jpapasinstru/CDIO3_Eq-4-_Atlektronik/02_Hardware/Source/README.md

Archivos editables: KiCad, Altium, Eagle
