jpapasinstru/CDIO3_Eq-4-_Atlektronik/02_Hardware/Mechanical/carcasas_cdio.docx

Proyecto CDIO 3

Golpeometro

Carcasas (hardware)

Juan pablo ciro Cardoso
1090273382
juanp.ciroc@uqvirtual.edu.co

Santiago Giraldo Dávila

1004917501

Santiago.giraldod@uqvirtual.edu.co

Docente
José Luis Chávez

Para la construcción de la estructura del golpeómetro se utilizó una combinación de materiales que permitieran soportar los impactos generados durante las pruebas y mantener estabilidad mecánica en el sistema. Como base principal se empleó un tablero de madera de alta densidad con dimensiones de 50 cm de ancho por 70 cm de alto. La madera se seleccionó debido a su buena resistencia mecánica y a su capacidad para absorber parte de las vibraciones producidas por los golpes, evitando deformaciones en la estructura.

Con el fin de reforzar la base y reducir movimientos no deseados, se instaló un armazón utilizando perfiles metálicos en ángulo de acero estructural. Este refuerzo permitió aumentar la rigidez del sistema y disminuir las vibraciones que podían afectar las mediciones realizadas por el sensor. Además, sobre esta estructura se construyó el soporte de la pera de boxeo, asegurando una fijación firme para evitar desplazamientos o holguras durante el impacto.

Uno de los aspectos más importantes del diseño fue lograr que la fuerza del golpe se transmitiera de manera controlada hacia la celda de carga. Para esto, se implementó un sistema de guiado junto con un rodachín que restringe movimientos laterales y de torsión, permitiendo únicamente un desplazamiento lineal y vertical. De esta forma, el impacto se dirige directamente sobre la celda de carga de 500 kg, reduciendo errores en la medición causados por fuerzas aplicadas fuera del eje principal.

Finalmente, la pera de boxeo se fijó a la estructura móvil mediante tornillería para garantizar estabilidad durante las pruebas. Por otro lado, la celda de carga fue instalada sobre la base de madera utilizando cinta doble faz industrial, lo que permitió realizar ajustes de posición durante la etapa inicial de pruebas y adquisición de datos con el módulo HX711 antes de realizar una fijación definitiva.

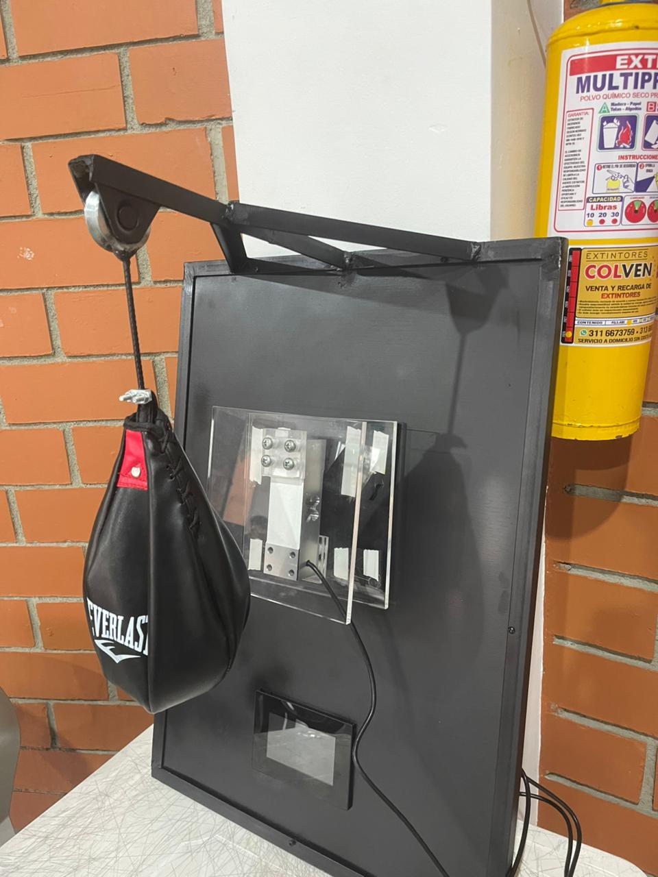
[picture p1: figure]
