jpapasinstru/CDIO3_Eq-4-_Atlektronik/04_Dossier/Atlektronik_expediente_tecnico (1).pdf

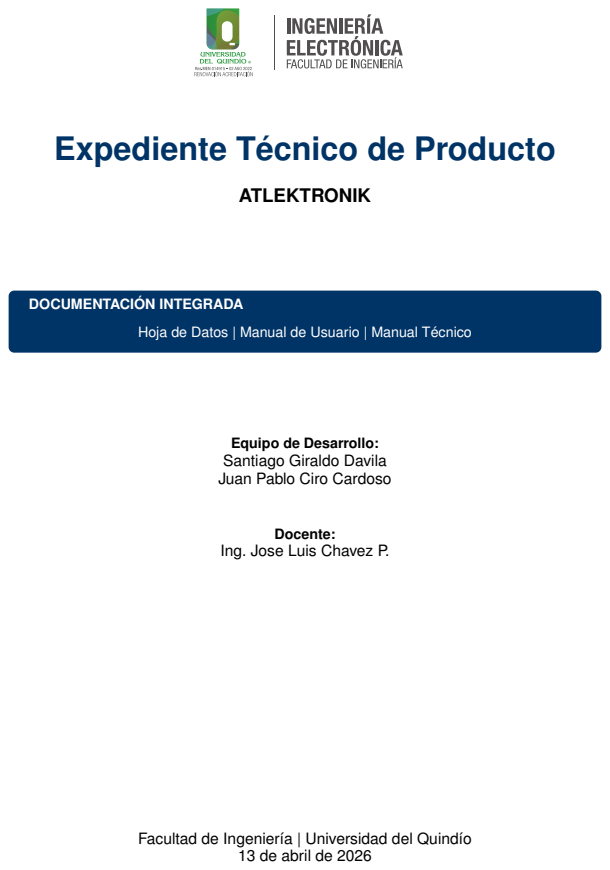
[picture p2: page 1]
ATLEKTRONIK; DOCUMENTACIÓN INTEGRADA; Docente:

Expediente Técnico de Producto

Hoja de Datos | Manual de Usuario | Manual Técnico

Equipo de Desarrollo:
Santiago Giraldo Davila
Juan Pablo Ciro Cardoso

Ing. Jose Luis Chavez P.

Facultad de Ingeniería | Universidad del Quindío

13 de abril de 2026

Proyecto CDIO III: ATLEKTRONIK | Rev. 1.0 - 2026

## Índice

1. HOJA DE DATOS (DATASHEET) | 2
2. MANUAL DE USUARIO | 3
3. MANUAL TÉCNICO | 4
Universidad del Quindío - Ingeniería Electrónica | 1

## 1 HOJA DE DATOS (DATASHEET)

### 1.1 Descripción General

Sistema de medición de fuerza de impacto con capacidad de 1000 kg (9806.65 N), procesamiento basado en ESP32 y visualización HMI en pantalla Nextion de alta corriente.

### 1.2 Especificaciones Eléctricas

Parámetro | Descripción | Valor/Unidad
Voltaje de Entrada | Suministrado por Fuente ATX | 5,0V DC
Corriente Nominal | Requerimiento de Pantalla Nextion | 1,0A
Resolución del Sensor | Módulo ADC HX711 | 24 bits
Rango de Medición | Límite físico de la celda de carga | 0 − 9806,65N
Frecuencia de Muestreo | Tasa de adquisición de datos | 10 − 80 Hz

### 1.3 Pinout (Diagrama de Conexiones)

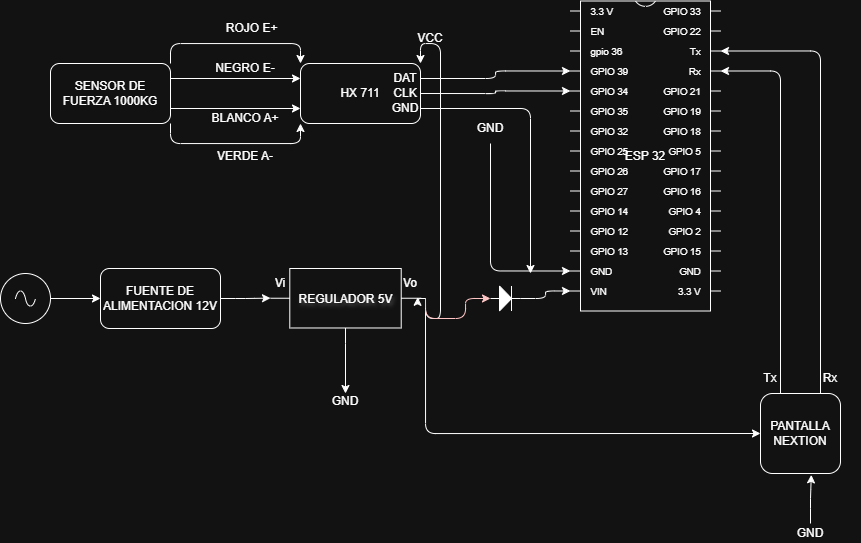
[picture p3: figure]

Figura 1: Diagrama de conexión detallado del sistema.

## 2 MANUAL DE USUARIO

. ADVERTENCIA DE SEGURIDAD

Alimentación: Utilice únicamente una fuente ATX que garantice una corriente mínima de 1,0A en la línea de 5V . Una corriente insuficiente causará fallos en el encendido de la pantalla Nextion.
Conexión AC: No manipule la fuente de poder conectada a la red de 110/220V AC.

### 2.1 Instrucciones de Operación

1. Verifique que el puente de encendido de la fuente ATX esté activo (Cable verde a tierra).
2. Conecte el dispositivo a la salida de 5V (Cables rojos de la fuente).
3. Encienda el sistema y espere la carga de la interfaz en la Nextion.
4. Ejecute el impacto sobre la pera de boxeo.
5. Visualice el valor de fuerza procesado en la pantalla.

## 3 MANUAL TÉCNICO

### 3.1 Arquitectura del Sistema y Conexiones

La arquitectura se basa en un lazo de control abierto donde la fuerza mecánica es convertida en señal eléctrica por el puente de Wheatstone de la celda de carga.

### 3.1.1. Conexión del Sensor (Código de Colores)

Siga estrictamente el siguiente orden de cableado para el módulo HX711:

E+ (Excitation+): Cable ROJO.

E- (Excitation-): Cable NEGRO.

A- (Signal-): Cable BLANCO.

A+ (Signal+): Cable VERDE.

### 3.1.2. Comunicación Serial (HMI Nextion)

Realice el cruce de líneas para habilitar la transmisión de datos:

TX (ESP32): Conecte al pin RX de la Pantalla Nextion.

RX (ESP32): Conecte al pin TX de la Pantalla Nextion.

GND: Asegure una tierra común entre la fuente, la ESP32 y la pantalla.

### 3.2 Lista de Materiales (BOM)

Referencia | Cant. | Especificación Técnica | Función
ESP32 DevKit V1 | 1 | Microcontrolador de 32 bits | Procesamiento
HX711 | 1 | ADC de alta resolución (24 bits) | Interfaz Celda
Celda de Carga | 1 | Tipo Pera - Capacidad 1 Tonelada | Transductor
Pantalla Nextion | 1 | HMI Serial - Req. 5V @ 1,0A | Visualización
Fuente ATX | 1 | Reciclada (110/220V AC a 5V DC) | Alimentación
1N5817 | 2 | Diodo Schottky de baja caída | Protección

### 3.3 Plan de Mantenimiento Preventivo

Actividad | Frecuencia | Procedimiento

Calibración de Fuerza 1000 impactos Compare con masa patrón de 10kg.
Limpieza de Fuente | Mensual | Retire residuos de polvo con aire comprimido.
Revisión de Cableado | Trimestral | Verifique continuidad en los cables de la galga.
