jpapasinstru/CDIO3_Eq-4-_Atlektronik/04_Dossier/HERRAMIENTAS DE AUDITORIA Y PLANEACIÓN.pdf

HERRAMIENTAS DE AUDITORIA Y PLANEACIÓN

CDIO lll

SANTIAGO GIRALDO DAVILA

JUAN PABLO CIRO CARDOSO

JOSE LUIS CHAVEZ

UNIVERSIDAD DEL QUINDIO

ARMENIA-QUINDIO

2026-l

1-Matriz de inventario

Es el control logístico que asegura la disponibilidad física de los insumos básicos, como resistencias y fuentes de voltaje, necesarios para las pruebas de laboratorio. Sirve para identificar rápidamente qué elementos ya están en stock y cuáles representan un riesgo para el cronograma si no se adquieren a tiempo.

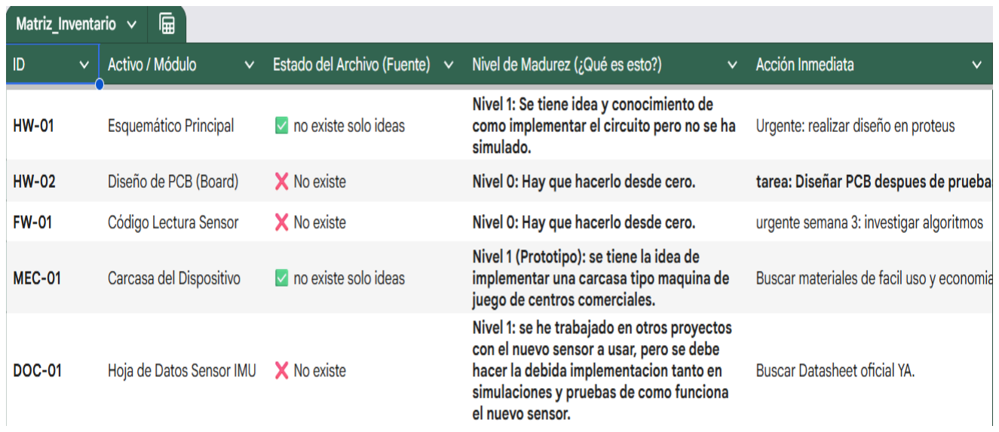
[picture p4: figure]

2-Inventario de subsistemas

Organiza los elementos del proyecto por bloques funcionales: el sistema de control (ESP32), el sistema de visualización (Nextion), el acondicionamiento de señal (HX711/AD620) y la estructura mecánica. Permite verificar la compatibilidad entre las diferentes etapas del "golpeómetro".

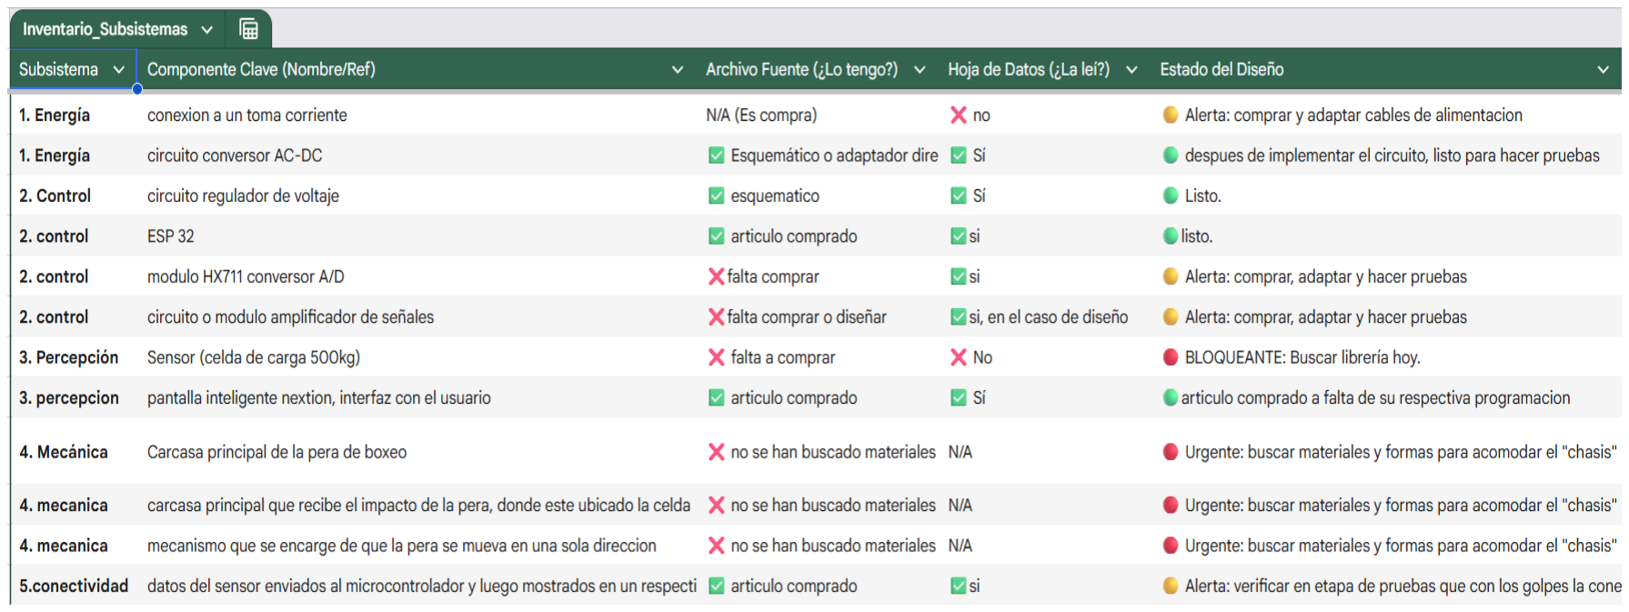
[picture p5: figure]

3-Auditoria de diseño

Documenta el proceso de revisión crítica del prototipo, donde se justifican cambios técnicos como la transición del sensor FSR a la celda de carga y el rediseño del mecanismo de la pera hacia un movimiento unidireccional. Evalúa si el diseño actual cumple con los requerimientos de precisión y resistencia.

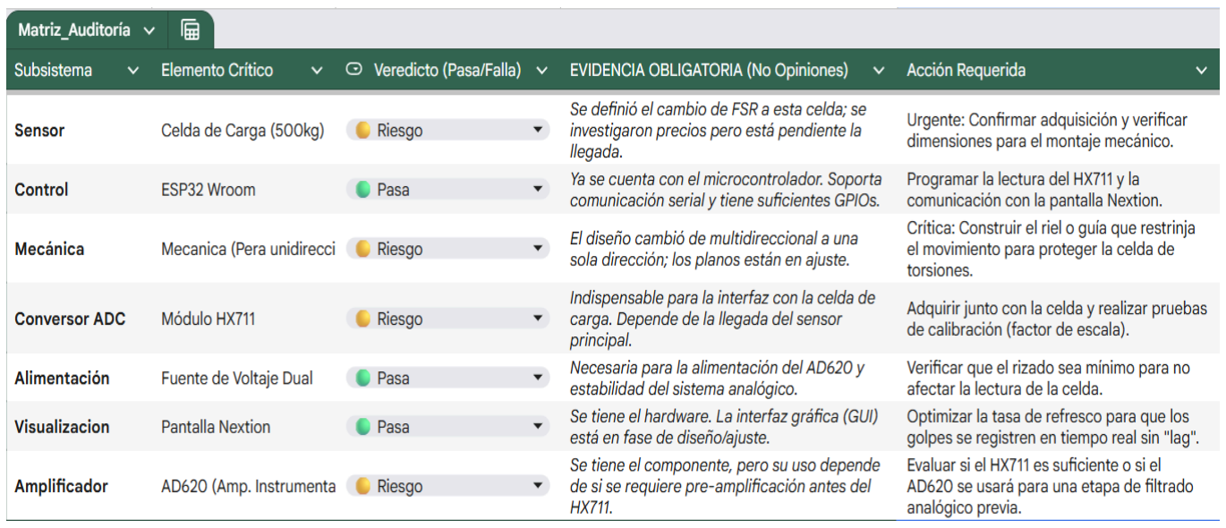
[picture p6: figure]

4- BOM sourcing

Centraliza la gestión de suministros, detallando cada componente electrónico y mecánico (desde la celda de carga de 500kg hasta el ESP32). Registra proveedores, costos y el estado de los pedidos para evitar retrasos en la etapa de implementación.

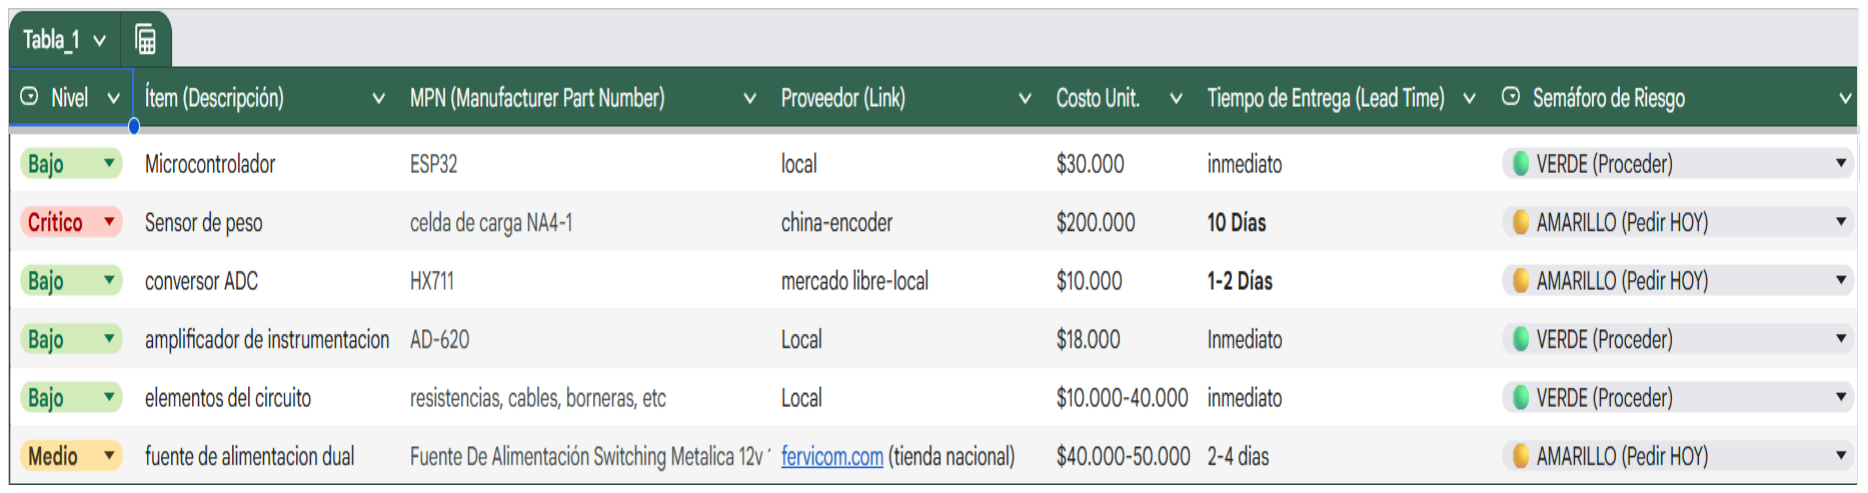
[picture p7: figure]

5-Planificador Sprint

Es la hoja de ruta del proyecto donde se desglosan las tareas críticas de compra, diseño y validación. Define los plazos de ejecución (como las pruebas de la celda entre las semanas 7 y 8) y establece los criterios de aceptación para asegurar que cada fase se complete con éxito antes de avanzar.

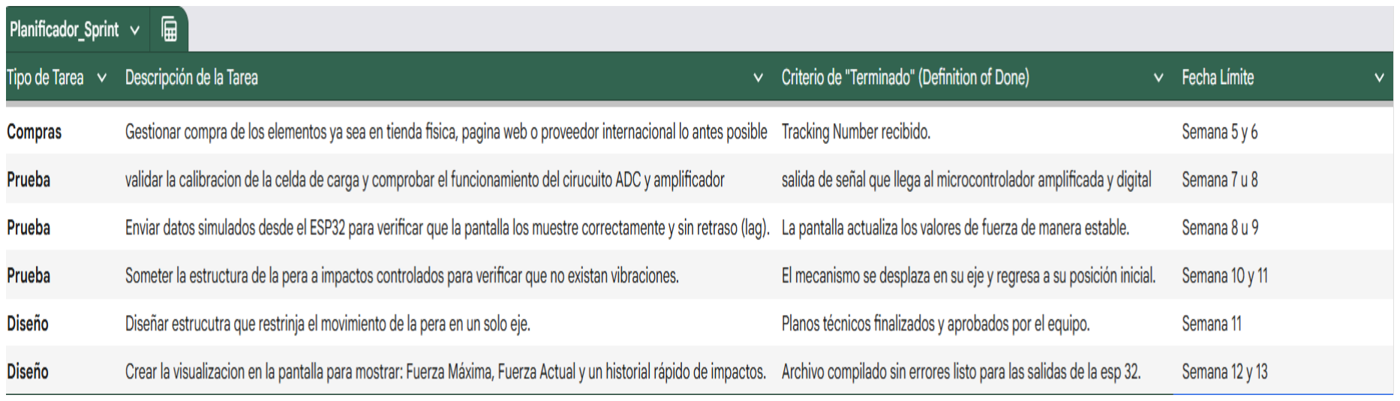
[picture p8: figure]

Diseño del prototipo en 3D (mecanismo)

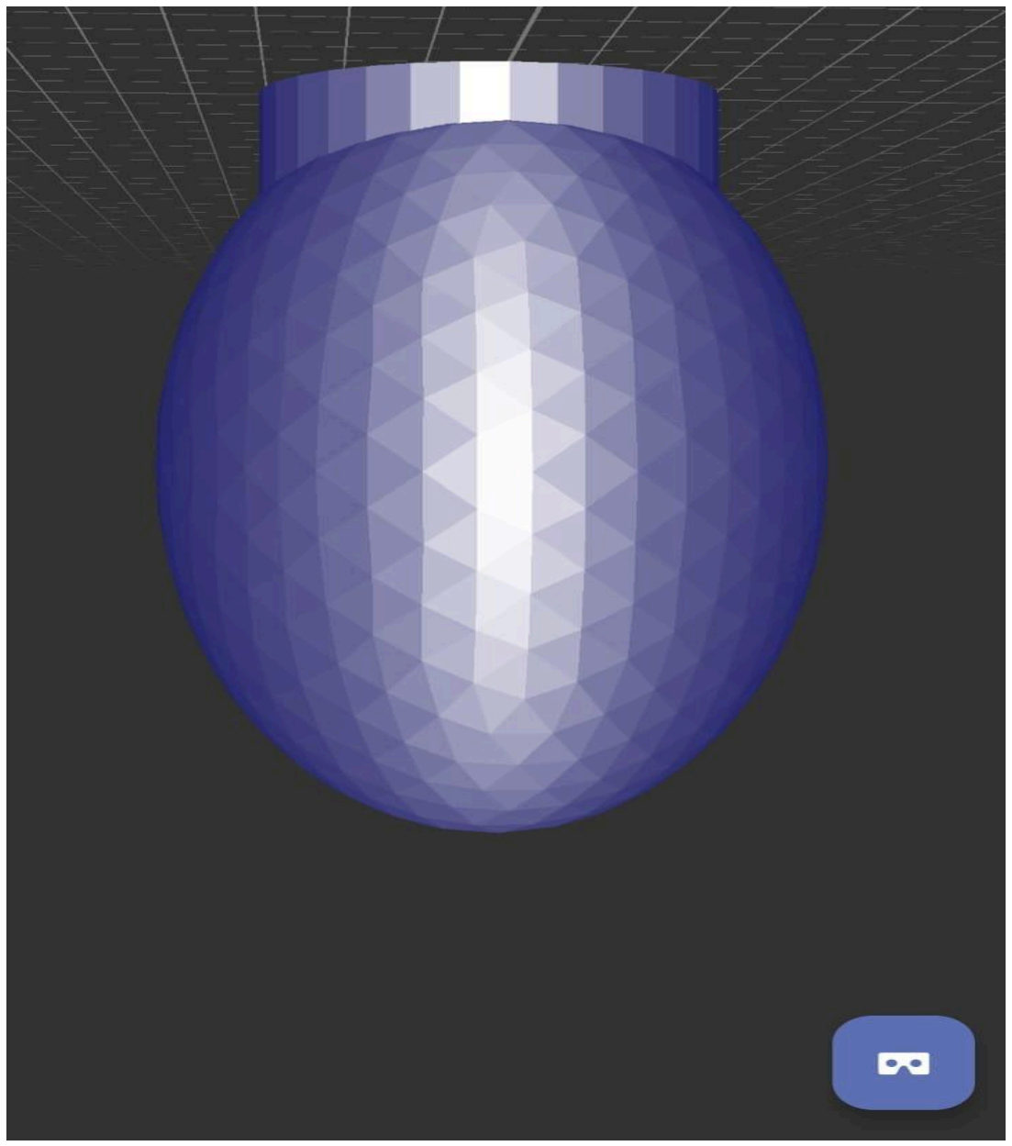
[picture p9: figure]
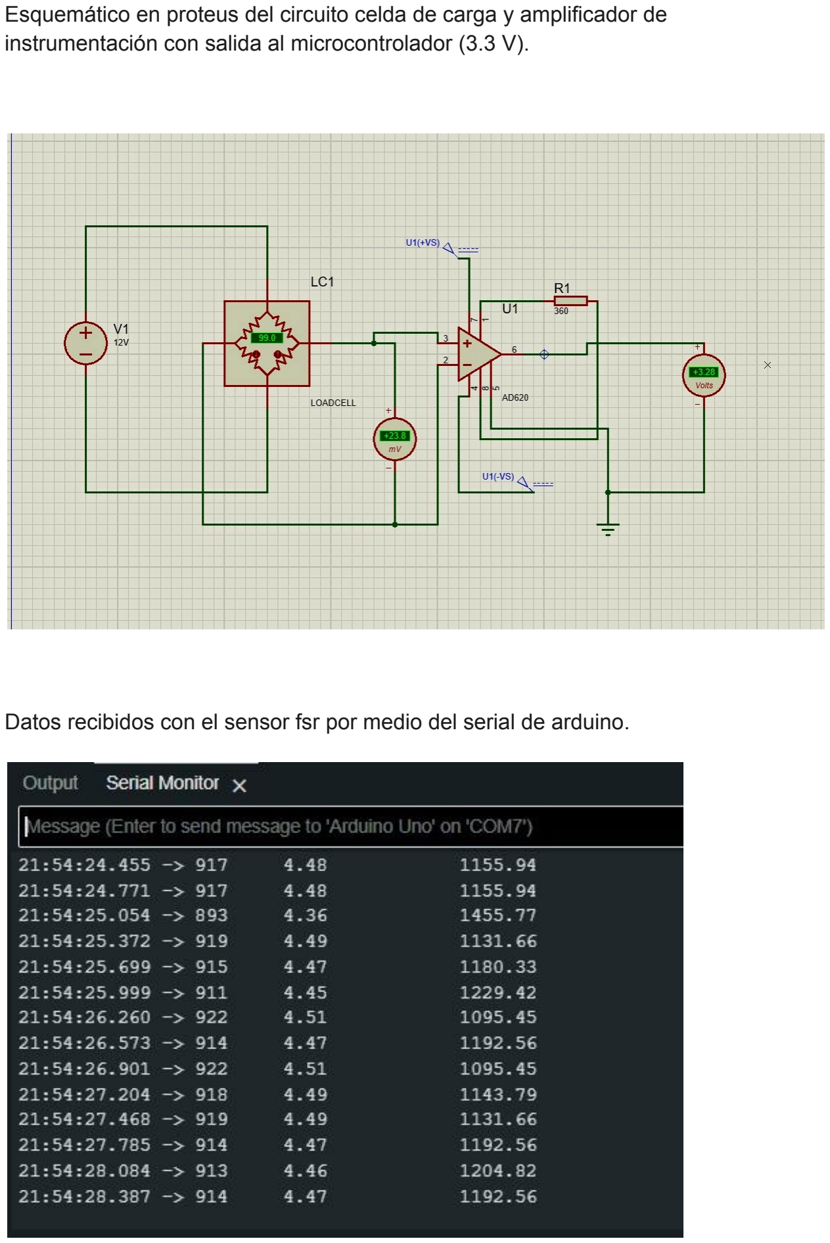
[picture p10: page 6]

Esquemático en proteus del circuito celda de carga y amplificador de instrumentación con salida al microcontrolador (3.3 V).

Datos recibidos con el sensor fsr por medio del serial de arduino.

Prototipo realizado con el profesor jorge alejandro aldana con estralandia mediante el cual se dio a conocer a pequeña escala de como podría ser la implementación del sistema de medición de fuerza de golpeo enfocada en un gimnasio de la liga del quindio de boxeo.

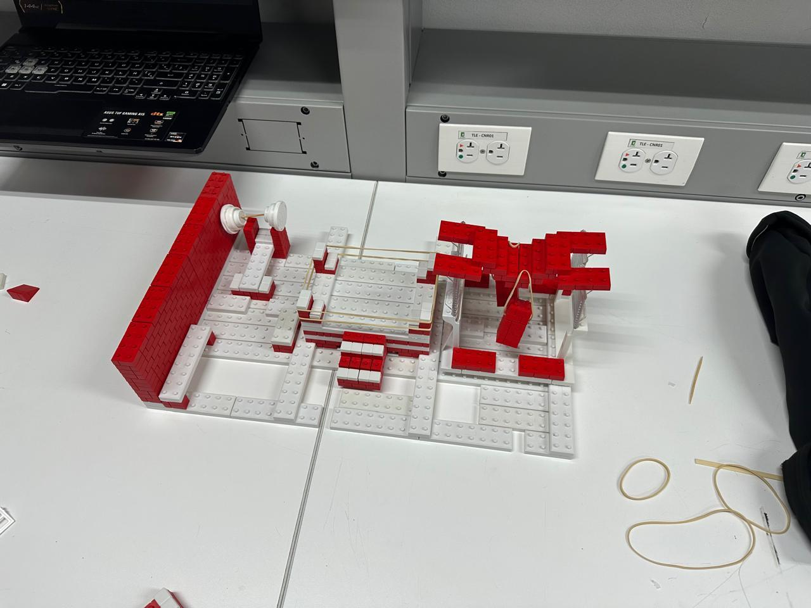
[picture p11: figure]

Auditoria tecnica

Evidencias del hardware “en camino” (sourcing).

Orden de compra del sensor principal (celda de carga).

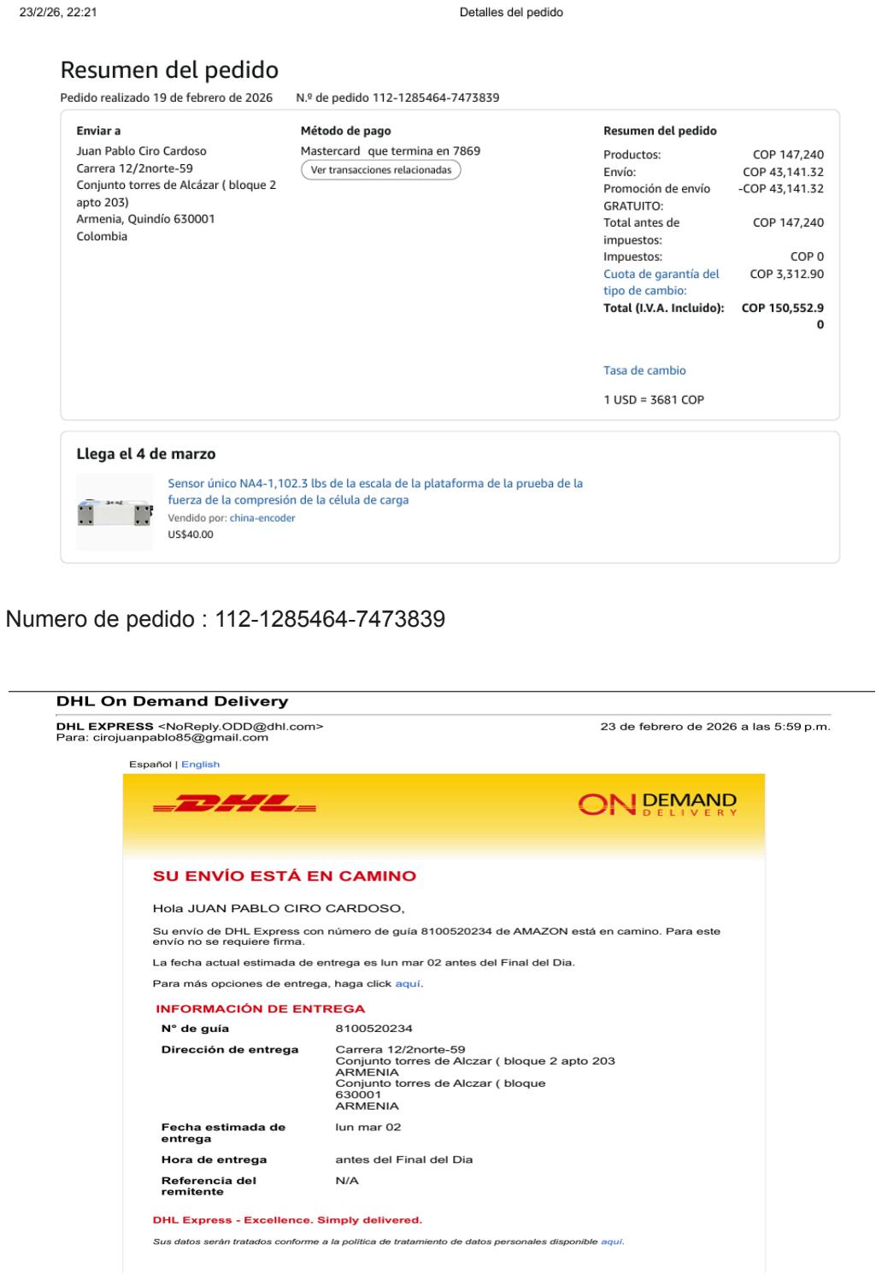
[picture p12: page 8]

Numero de pedido : 112-1285464-7473839

Descripción del sensor (cuadro comparativo con las especificaciones propuestas en CDIO ll):

Parámetro / Requisito | Valor Objetivo (Planeación) | Especificació n Celda NA4 | ¿Cumple ? | Observación Técnica
Rango de Medición | 0 a 5000 N (502 kg) | Capacidades de 60 a 800kg | SÍ | La capacidad de hasta 800 kg cubre perfectament e el rango de un golpe recreativo.
Repetibilida d | < 5% | +/- 0.02% F.S. | SÍ | La precisión de la celda es muy superior al requisito mínimo del 5%.
Protección / Ambiente | Uso rudo (Golpe de boxeo) | Grado de protección IP66/IP67 | SÍ | El sellado IP67 garantiza durabilidad frente a polvo y humedad durante las pruebas.

Sobrecarga Segura | No especificado explícitament e | <150% F.S. | SÍ | Soporta hasta 750 kg sin daño permanente, ideal para impactos accidentales fuertes.
Voltaje de Salida | Salida analógica para ADC | 2.0 mV/V +/-5% | SÍ | Compatible con el módulo HX711 mencionado en su planificador.
