jpapasinstru/CDIO3_Eq-4-_Atlektronik/04_Dossier/desarrollo del proyecto en ciclos i´pac.docx

INFORME DE DESARROLLO DEL PROYECTO GOLPEÓMETRO MEDIANTE CICLOS IPAC

CURSO CDIO 3

Integrantes:

Juan Pablo Ciro Cardoso

1090273382

Juanp.ciroc@uqvirtual.edu.co

Santiago Giraldo Dávila

1004917501

Santiago.giraldod@uqvirtual.edu.co

Facultad de ingeniería

Programa de ingeniería electrónica

Curso Cdio 3

Docente

José Luis Chávez P.

Introducción: El desarrollo del proyecto Golpeómetro se llevó a cabo siguiendo la metodología CDIO junto con la organización por ciclos IPAC, permitiendo dividir el trabajo en diferentes etapas y mantener un control más claro tanto del avance técnico como de la gestión del proyecto. Durante el proceso se utilizaron herramientas de seguimiento tipo Kanban para organizar tareas de diseño, implementación, pruebas y validación, facilitando la distribución del trabajo dentro del equipo.

El proyecto tuvo como objetivo el diseño de un sistema capaz de medir la fuerza de impacto de un golpe utilizando una celda de carga, un sistema de adquisición basado en ESP32 y una interfaz gráfica para la visualización de datos. A medida que avanzó el desarrollo, fue necesario abordar problemas mecánicos, electrónicos y de procesamiento de señales, por lo que el proyecto se dividió en varios ciclos IPAC enfocados en resolver necesidades específicas del sistema.

IPAC I – Planeación inicial y selección de componentes

Durante la primera etapa del proyecto se definieron los requerimientos generales del sistema y la arquitectura principal del golpeómetro. En esta fase se establecieron las variables más importantes del diseño, como el rango de fuerza esperado, el tipo de sensor a utilizar, la capacidad de procesamiento y la forma en que se visualizarían los datos obtenidos.

Inicialmente se realizó la búsqueda y validación de los componentes principales mediante revisión de hojas de datos y análisis de compatibilidad entre módulos. Para la adquisición de fuerza se seleccionó una celda de carga tipo Single Point de 500 kg, junto con el módulo HX711 para el acondicionamiento y digitalización de la señal. Como unidad principal de procesamiento se utilizó un ESP32 debido a la cantidad de periféricos disponibles y su facilidad para manejar comunicación serial y procesamiento de datos en tiempo real. Además, se escogió una pantalla Nextion para la interfaz gráfica del sistema.

En esta etapa también se organizó la compra de materiales y componentes necesarios para la construcción del prototipo. Una vez recibidos y verificados todos los elementos principales, se dio por finalizada la primera fase del proyecto.

IPAC II – Construcción estructural y adquisición de señal

En el segundo ciclo el trabajo se enfocó principalmente en la parte mecánica y en la estabilidad de la señal obtenida desde la celda de carga. Uno de los principales problemas identificados desde el inicio fue que las vibraciones generadas por los impactos podían afectar directamente las mediciones, introduciendo ruido en la señal.

Para solucionar esto, se construyó una base utilizando madera de alta densidad con dimensiones de 50 cm por 70 cm, buscando una estructura resistente y capaz de absorber parte de las vibraciones producidas durante los golpes. Posteriormente, se reforzó el sistema mediante perfiles metálicos en ángulo para aumentar la rigidez de la estructura y evitar deformaciones o movimientos no deseados.

Después de finalizar la estructura principal, se realizó el montaje de la celda de carga y el módulo HX711. Durante esta etapa también se trabajó en el cableado y blindaje de las señales, conectando adecuadamente la malla de protección a tierra para reducir interferencias eléctricas y ruido electromagnético que pudieran afectar las lecturas del sensor.

Finalmente, se realizaron las primeras pruebas de adquisición de datos, verificando que el sistema fuera capaz de registrar señales estables y repetibles desde la celda de carga.

IPAC III – Sistema mecánico de impacto y diseño electrónico

En esta etapa el proyecto se centró en mejorar la forma en que la fuerza del golpe llegaba a la celda de carga. Durante las pruebas iniciales se observó que los impactos diagonales o no completamente centrados, producían errores en las mediciones debido a impactos que no golpeaban la celda de carga en el punto correcto.

Para reducir este problema, se diseñó un mecanismo de guiado que restringe el movimiento únicamente en dirección vertical. El sistema se construyó utilizando soportes metálicos y un rodachín que actúa como guía, permitiendo que la fuerza del golpe se transmita directamente hacia la celda de carga sin movimientos laterales significativos.

A la vez, se trabajó en el diseño de la PCB del sistema utilizando Proteus. En esta fase se definieron los caminos de potencia o alimentación, conexiones del ESP32, alimentación del HX711 y la interfaz con la pantalla Nextion. Posteriormente, la placa pcb fue fabricada mediante la máquina CNC del laboratorio.

También se desarrolló la interfaz gráfica de usuario en la pantalla Nextion, mostrando variables como fuerza máxima, fuerza actual e historial básico de mediciones. Finalmente, se realizaron pruebas de comunicación serial y validación del sistema electrónico completo.

IPAC IV – Integración final y validación del sistema

La última etapa estuvo enfocada en integrar todos los subsistemas y realizar las pruebas finales de funcionamiento. En este punto ya se contaba con la estructura mecánica, el sistema electrónico y la adquisición de datos operando de manera conjunta.

En el software del ESP32 se implementaron filtros en el código para estabilizar las lecturas y reducir las variaciones causadas por rebotes mecánicos después del impacto. Además, se desarrolló un sistema básico de almacenamiento de datos para registrar usuarios y resultados obtenidos durante las pruebas.

Con el fin de mejorar la estabilidad general del prototipo, se añadieron refuerzos adicionales en la base utilizando arena como un peso mayor a la pera, para disminuir vibraciones o errores en el censado. Asimismo, la fijación de la celda de carga pasó de un montaje temporal con cinta industrial a una sujeción casi semi permanente mediante tornillos y pernos a una pared gruesa.

Finalmente, se realizaron pruebas completas de funcionamiento y calibración del sistema, verificando la respuesta del sensor, la estabilidad mecánica y la correcta visualización de datos en la interfaz gráfica. Con esto se logró obtener un prototipo funcional y estable, capaz de medir impactos de forma repetible y con un margen de error reducido.
