jpapasinstru/CDIO3_Eq-4-_Atlektronik/01_Gestion/03 - Acta_Reuniones CDIO lll.docx (2).pdf

## Universidad del Quindío. Programa de Ingeniería Electrónica

# ACTA DE REUNIÓN DEL EQUIPO

Por cada reunión que se agende para el equipo de trabajo, se debe diligenciar esta acta. Las actas deben ser almacenadas en el portafolio.

Número ID. Equipo: | 2K | Nombre del Equipo: | ATLEKTRONIK
Fecha: | [04-02-26] | Hora de Inicio: 11 am | Hora de Finalización: 1 pm
Lugar: | universidad del quindío (bloque ingenieria)
Product Manager: | Relator: | juan pablo ciro cardoso
PROPÓSITO DE LA REUNIÓN: | Validar la viabilidad técnica del prototipo diseñado en CDIO II y determinar si los componentes actuales cumplen con los requerimientos de impacto y precisión.
METAS ALCANZADAS: | 1. Evaluación del prototipo ideal frente a condiciones reales de impacto. 2. Decisión técnica de sustituir el sensor FSR por una celda de carga, debido a la necesidad de mayor precisión y durabilidad. 3. Investigación de mercado y selección de una celda de carga de 500 kg.
TAREAS PENDIENTES Y RESPONSABLES: | 1. Finalizar la compra/adquisición de la celda de carga de 500 kg. Juan Pablo Ciro Cardoso 2. Investigar el módulo amplificador (HX711 o similar) para la nueva celda. Santiago Giraldo Davila
FIRMAS DE LOS ASISTENTES 1 : | 1. SANTIAGO GIRALDO DAVILA Nombre:SANTIAGO GIRALDO DÁVILA. 2. JUAN PABLO CIRO CARDOSO Nombre:JUAN PABLO CIRO CARDOSO
OBSERVACIONES: | Se determinó que los sensores FSR presentaban saturación y poca linealidad para los niveles de fuerza esperados en el "golpeómetro". _______________________________________________________________________________________

1 El integrante que no asista a la reunión no podrá firmar en otra ocasión, en su lugar, debe escribirse “AUSENTE”; sin embargo, si le podrán ser asignadas responsabilidades.

## Acta de Reunión del Equipo

## Universidad del Quindío. Programa de Ingeniería Electrónica

Número ID. Equipo: | 2K | Nombre del Equipo: | ATLEKTRONIK
Fecha: | [11-02-26] | Hora de Inicio: 11 am | Hora de Finalización: 1 pm
Lugar: | universidad del quindío (bloque ingenieria)
Product Manager: | Relator: | juan pablo ciro cardoso
PROPÓSITO DE LA REUNIÓN: | Investigar opciones sobre como adaptar la estructura física al nuevo sensor y cumplir con los estándares de modelado de procesos exigidos.
METAS ALCANZADAS: | 1. Rediseño del mecanismo de la pera para restringir el movimiento a una sola dirección (eje lineal), garantizando que la fuerza se aplique perpendicularmente a la celda de carga. 2. Actualización de la documentación técnica, específicamente el diagrama IDEF0 (siguiendo las correcciones del docente).
TAREAS PENDIENTES Y RESPONSABLES: | 1. Definir el nuevo plano mecánico con el eje de movimiento restringido. Juan Pablo Ciro Cardoso 2. Subir la versión corregida del IDEF0 al informe de avance. Santiago Giraldo Davila
FIRMAS DE LOS ASISTENTES 2 : | 1. SANTIAGO GIRALDO DAVILA Nombre:SANTIAGO GIRALDO DÁVILA. 2. JUAN PABLO CIRO CARDOSO Nombre:JUAN PABLO CIRO CARDOSO
OBSERVACIONES: | Se determinó que el movimiento lineal de la pera es fundamental para asi el impacto sea netamente en la celda de carga. _______________________________________________________________________________________

2 El integrante que no asista a la reunión no podrá firmar en otra ocasión, en su lugar, debe escribirse “AUSENTE”; sin embargo, si le podrán ser asignadas responsabilidades.

## Universidad del Quindío. Programa de Ingeniería Electrónica

Número ID. Equipo: | 2K | Nombre del Equipo: | ATLEKTRONIK
Fecha: | [18-02-26] | Hora de Inicio: 11 am | Hora de Finalización: 1 pm
Lugar: | universidad del quindío (bloque ingenieria)
Product Manager: | Relator: | Santiago Giraldo Davila
PROPÓSITO DE LA REUNIÓN: | Centralizar toda la información técnica y el código fuente del proyecto para asegurar la trazabilidad y el trabajo colaborativo.
METAS ALCANZADAS: | 1. Creación y configuración del repositorio en GitHub para el proyecto. 2. Migración de archivos (código y documentación) al entorno de Git. 3. Organización de la estructura de carpetas (Hardware,Firmware, Software, Dossier).
TAREAS PENDIENTES Y RESPONSABLES: | 1. Subir los últimos cambios de la programación de la celda de carga al repositorio. Juan Pablo Ciro Cardoso 2. Verificar que todos los integrantes tengan acceso y permisos de edición en GitHub. Santiago Giraldo Davila
FIRMAS DE LOS ASISTENTES 3 : | 1. SANTIAGO GIRALDO DAVILA Nombre:SANTIAGO GIRALDO DÁVILA. 2. JUAN PABLO CIRO CARDOSO Nombre:JUAN PABLO CIRO CARDOSO
OBSERVACIONES: | N/A _______________________________________________________________________________________

3 El integrante que no asista a la reunión no podrá firmar en otra ocasión, en su lugar, debe escribirse “AUSENTE”; sin embargo, si le podrán ser asignadas responsabilidades.

## Universidad del Quindío. Programa de Ingeniería Electrónica

Número ID. Equipo: | 2K | Nombre del Equipo: | ATLEKTRONIK
Fecha: | [25-02-26] | Hora de Inicio: 11 am | Hora de Finalización: 1 pm
Lugar: | Universidad del quindío (bloque ingenieria)
Product Manager: | Relator: | Santiago Giraldo Davila
PROPÓSITO DE LA REUNIÓN: | Socializar sobre el github, funcionamiento, carpetas, y tareas futuras
METAS ALCANZADAS: | 1. Se subieron los archivos del entregable. 2. Se organizo un poco mejor el tablero canvas. 3. Se distribuyeron mejor las tareas a realizar cuando lleguen los implementos.
TAREAS PENDIENTES Y RESPONSABLES: | 1. Investigar sobre la base de donde estara ubicada nuestra celda de carga. Santiago Giraldo Davila 2. Investigar sobre el sistema de movimiento en un solo eje. Juan Pablo Ciro Cardoso 3.Investigar sobre desarrollo de base de datos. Santiago Giraldo Davila
FIRMAS DE LOS ASISTENTES 4 : | 1. SANTIAGO GIRALDO DAVILA Nombre:SANTIAGO GIRALDO DÁVILA. 2. JUAN PABLO CIRO CARDOSO Nombre:JUAN PABLO CIRO CARDOSO
OBSERVACIONES: | N/A _________________________________________________________________________________

4 El integrante que no asista a la reunión no podrá firmar en otra ocasión, en su lugar, debe escribirse “AUSENTE”; sin embargo, si le podrán ser asignadas responsabilidades.

## Universidad del Quindío. Programa de Ingeniería Electrónica

5 El integrante que no asista a la reunión no podrá firmar en otra ocasión, en su lugar, debe escribirse “AUSENTE”; sin embargo, si le podrán ser asignadas responsabilidades.

Número ID. Equipo: | 2K | Nombre del Equipo: | ATLEKTRONIK
Fecha: | [25-03-05] | Hora de Inicio: 11 am | Hora de Finalización: 1 pm
Lugar: | Universidad del quindío (bloque ingenieria)
Product Manager: | Relator: | Santiago Giraldo Davila
PROPÓSITO DE LA REUNIÓN: | Definir el alcance del proyecto CDIO, lluvia de ideas y análisis de requerimientos principales.
METAS ALCANZADAS: | 1. Se definió la idea central del sistema automatizado. 2. Se establecieron los requerimientos básicos de hardware (celda de carga y movimiento).
TAREAS PENDIENTES Y RESPONSABLES: | 1. Buscar referencias de celdas de carga y sus módulos amplificadores. (Juan Pablo Ciro Cardoso) 2. Investigar requerimientos para el motor de la base de datos. (Santiago Giraldo Davila)
FIRMAS DE LOS ASISTENTES 5 : | 1. SANTIAGO GIRALDO DAVILA Nombre:SANTIAGO GIRALDO DÁVILA. 2. JUAN PABLO CIRO CARDOSO Nombre:JUAN PABLO CIRO CARDOSO
OBSERVACIONES: | N/A _________________________________________________________________________________

## Universidad del Quindío. Programa de Ingeniería Electrónica

6 El integrante que no asista a la reunión no podrá firmar en otra ocasión, en su lugar, debe escribirse “AUSENTE”; sin embargo, si le podrán ser asignadas responsabilidades.

Número ID. Equipo: | 2K | Nombre del Equipo: | ATLEKTRONIK
Fecha: | [25-03-12] | Hora de Inicio: 11 am | Hora de Finalización: 1 pm
Lugar: | Universidad del quindío (bloque ingenieria)
Product Manager: | Relator: | Santiago Giraldo Davila
PROPÓSITO DE LA REUNIÓN: | Diseño conceptual, selección preliminar de componentes y distribución de tareas de investigación.
METAS ALCANZADAS: | 1. Se seleccionó el módulo HX711 para la celda de carga. 2. Se acordó el lenguaje de programación y el motor de base de datos a usar.
TAREAS PENDIENTES Y RESPONSABLES: | 1. Empezar bocetos del chasis y soporte del sistema de movimiento. (Juan Pablo Ciro Cardoso) 2. Crear el repositorio inicial y estructura del proyecto. (Santiago Giraldo Davila)
FIRMAS DE LOS ASISTENTES 6 : | 1. SANTIAGO GIRALDO DAVILA Nombre:SANTIAGO GIRALDO DÁVILA. 2. JUAN PABLO CIRO CARDOSO Nombre:JUAN PABLO CIRO CARDOSO
OBSERVACIONES: | N/A _________________________________________________________________________________

## Universidad del Quindío. Programa de Ingeniería Electrónica

7 El integrante que no asista a la reunión no podrá firmar en otra ocasión, en su lugar, debe escribirse “AUSENTE”; sin embargo, si le podrán ser asignadas responsabilidades.

Número ID. Equipo: | 2K | Nombre del Equipo: | ATLEKTRONIK
Fecha: | [25-03-19] | Hora de Inicio: 11 am | Hora de Finalización: 1 pm
Lugar: | Universidad del quindío (bloque ingenieria)
Product Manager: | Relator: | Santiago Giraldo Davila
PROPÓSITO DE LA REUNIÓN: | Revisión de diseños preliminares mecánicos y planificación de la arquitectura de software.
METAS ALCANZADAS: | 1. Primeros bocetos del sistema de movimiento de un solo eje aprobados. 2. Estructura de tablas para la base de datos definida en papel.
TAREAS PENDIENTES Y RESPONSABLES: | 1. Pasar el diseño del chasis en plano.. (Juan Pablo Ciro Cardoso) 2. Instalar el entorno de desarrollo y crear las tablas en la base de datos local. (Santiago Giraldo Davila)
FIRMAS DE LOS ASISTENTES 7 : | 1. SANTIAGO GIRALDO DAVILA Nombre:SANTIAGO GIRALDO DÁVILA. 2. JUAN PABLO CIRO CARDOSO Nombre:JUAN PABLO CIRO CARDOSO
OBSERVACIONES: | N/A _________________________________________________________________________________

## Universidad del Quindío. Programa de Ingeniería Electrónica

8 El integrante que no asista a la reunión no podrá firmar en otra ocasión, en su lugar, debe escribirse “AUSENTE”; sin embargo, si le podrán ser asignadas responsabilidades.

Número ID. Equipo: | 2K | Nombre del Equipo: | ATLEKTRONIK
Fecha: | [25-03-26] | Hora de Inicio: 11 am | Hora de Finalización: 1 pm
Lugar: | Universidad del quindío (bloque ingenieria)
Product Manager: | Relator: | Santiago Giraldo Davila
PROPÓSITO DE LA REUNIÓN: | Consolidar la lista de materiales (BOM), revisar el CAD y preparar el primer entregable del semestre.
METAS ALCANZADAS: | 1. Lista de materiales finalizada y cotizada. 2. Documento del primer entregable redactado al 90%.
TAREAS PENDIENTES Y RESPONSABLES: | 1. Realizar la compra de los implementos electrónicos. (Ambos) 2. Terminar correcciones de formato del documento entregable. (Santiago Giraldo Davila) .
FIRMAS DE LOS ASISTENTES 8 : | 1. SANTIAGO GIRALDO DAVILA Nombre:SANTIAGO GIRALDO DÁVILA. 2. JUAN PABLO CIRO CARDOSO Nombre:JUAN PABLO CIRO CARDOSO
OBSERVACIONES: | Se debe hacer el pedido de piezas lo antes posible para evitar retrasos en envíos. _________________________________________________________________________________

## Universidad del Quindío. Programa de Ingeniería Electrónica

9 El integrante que no asista a la reunión no podrá firmar en otra ocasión, en su lugar, debe escribirse “AUSENTE”; sin embargo, si le podrán ser asignadas responsabilidades.

Número ID. Equipo: | 2K | Nombre del Equipo: | ATLEKTRONIK
Fecha: | [25-04-02] | Hora de Inicio: 11 am | Hora de Finalización: 1 pm
Lugar: | Universidad del quindío (bloque ingenieria)
Product Manager: | Relator: | Santiago Giraldo Davila
PROPÓSITO DE LA REUNIÓN: | Recepción de materiales y primeras pruebas unitarias de los sensores.
METAS ALCANZADAS: | 1. Recepción y revisión de la celda de carga y actuadores mecánicos. 2. Primera lectura exitosa de la celda de carga usando Arduino/Microcontrolador en protoboard.
TAREAS PENDIENTES Y RESPONSABLES: | 1. Iniciar el ensamble físico del sistema de un eje. (Juan Pablo Ciro Cardoso) 2. Escribir el script para enviar datos seriales a la base de datos. (Santiago Giraldo Davila)
FIRMAS DE LOS ASISTENTES 9 : | 1. SANTIAGO GIRALDO DAVILA Nombre:SANTIAGO GIRALDO DÁVILA. 2. JUAN PABLO CIRO CARDOSO Nombre:JUAN PABLO CIRO CARDOSO
OBSERVACIONES: | La celda de carga requiere una calibración más fina. _________________________________________________________________________________

## Universidad del Quindío. Programa de Ingeniería Electrónica

10 El integrante que no asista a la reunión no podrá firmar en otra ocasión, en su lugar, debe escribirse “AUSENTE”; sin embargo, si le podrán ser asignadas responsabilidades.

Número ID. Equipo: | 2K | Nombre del Equipo: | ATLEKTRONIK
Fecha: | [25-04-09] | Hora de Inicio: 11 am | Hora de Finalización: 1 pm
Lugar: | Universidad del quindío (bloque ingenieria)
Product Manager: | Relator: | Santiago Giraldo Davila
PROPÓSITO DE LA REUNIÓN: | Ensamblaje mecánico del sistema de movimiento e integración de hardware.
METAS ALCANZADAS: | 1. El riel/sistema de movimiento de un eje quedó ensamblado. . 2. La base para la celda de carga fue montada exitosamente en la estructura.
TAREAS PENDIENTES Y RESPONSABLES: | 1. Cableado final de motores y sensores a la placa de control. (Juan Pablo Ciro Cardoso) 2. Pruebas de conexión entre el software y la base de datos. (Santiago Giraldo Davila)
FIRMAS DE LOS ASISTENTES 10 : | 1. SANTIAGO GIRALDO DAVILA Nombre:SANTIAGO GIRALDO DÁVILA. 2. JUAN PABLO CIRO CARDOSO Nombre:JUAN PABLO CIRO CARDOSO
OBSERVACIONES: | La celda de carga requiere una calibración más fina. _________________________________________________________________________________

## Universidad del Quindío. Programa de Ingeniería Electrónica

11 El integrante que no asista a la reunión no podrá firmar en otra ocasión, en su lugar, debe escribirse “AUSENTE”; sin embargo, si le podrán ser asignadas responsabilidades.

Número ID. Equipo: | 2K | Nombre del Equipo: | ATLEKTRONIK
Fecha: | [25-04-16] | Hora de Inicio: 11 am | Hora de Finalización: 1 pm
Lugar: | Universidad del quindío (bloque ingenieria)
Product Manager: | Relator: | Santiago Giraldo Davila
PROPÓSITO DE LA REUNIÓN: | Integración conjunta de hardware (mecánica + electrónica) con el software de almacenamiento.
METAS ALCANZADAS: | 1. El motor del eje responde correctamente a las instrucciones del código. . 2. Se logró insertar el primer registro de peso en la base de datos automáticamente.
TAREAS PENDIENTES Y RESPONSABLES: | 1. Corregir fricciones mecánicas en el eje de movimiento. (Juan Pablo Ciro Cardoso) 2. Filtrar el ruido en la lectura de la celda de carga por software. (Santiago Giraldo Davila)
FIRMAS DE LOS ASISTENTES 11 : | 1. SANTIAGO GIRALDO DAVILA Nombre:SANTIAGO GIRALDO DÁVILA. 2. JUAN PABLO CIRO CARDOSO Nombre:JUAN PABLO CIRO CARDOSO
OBSERVACIONES: | Se nota inestabilidad en las lecturas de peso cuando el motor está encendido (posible ruido eléctrico). La celda de carga requiere una calibración más fina. _________________________________________________________________________________

## Universidad del Quindío. Programa de Ingeniería Electrónica

12 El integrante que no asista a la reunión no podrá firmar en otra ocasión, en su lugar, debe escribirse “AUSENTE”; sin embargo, si le podrán ser asignadas responsabilidades.

Número ID. Equipo: | 2K | Nombre del Equipo: | ATLEKTRONIK
Fecha: | [25-04-23] | Hora de Inicio: 11 am | Hora de Finalización: 1 pm
Lugar: | Universidad del quindío (bloque ingenieria)
Product Manager: | Relator: | Santiago Giraldo Davila
PROPÓSITO DE LA REUNIÓN: | Pruebas de sistema completo y corrección de bugs de integración.
METAS ALCANZADAS: | 1. Se solucionó el problema de ruido eléctrico aislando la alimentación. . 2. El sistema realiza un ciclo completo: moverse, detenerse, pesar y guardar.
TAREAS PENDIENTES Y RESPONSABLES: | 1. Diseñar piezas en impresión 3D para acoples faltantes. (Juan Pablo Ciro Cardoso) 2. Desarrollar una interfaz gráfica o dashboard simple para visualizar los datos. (Santiago Giraldo Davila)
FIRMAS DE LOS ASISTENTES 12 : | 1. SANTIAGO GIRALDO DAVILA Nombre:SANTIAGO GIRALDO DÁVILA. 2. JUAN PABLO CIRO CARDOSO Nombre:JUAN PABLO CIRO CARDOSO
OBSERVACIONES: | N/A _________________________________________________________________________________

## Universidad del Quindío. Programa de Ingeniería Electrónica

13 El integrante que no asista a la reunión no podrá firmar en otra ocasión, en su lugar, debe escribirse “AUSENTE”; sin embargo, si le podrán ser asignadas responsabilidades.

Número ID. Equipo: | 2K | Nombre del Equipo: | ATLEKTRONIK
Fecha: | [25-04-30] | Hora de Inicio: 11 am | Hora de Finalización: 1 pm
Lugar: | Universidad del quindío (bloque ingenieria)
Product Manager: | Relator: | Santiago Giraldo Davila
PROPÓSITO DE LA REUNIÓN: | Calibración final del sistema, validación de tolerancias y avance de interfaz gráfica.
METAS ALCANZADAS: | 1. Error de la celda de carga reducido a niveles aceptables (< 5%). . 2. Interfaz gráfica básica funcionando y conectada a la BD.
TAREAS PENDIENTES Y RESPONSABLES: | 1. Realizar 50 pruebas de estrés operativas continuas. (Ambos) 2. Iniciar la redacción del manual técnico y de usuario. (Santiago Giraldo Davila)
FIRMAS DE LOS ASISTENTES 13 : | 1. SANTIAGO GIRALDO DAVILA Nombre:SANTIAGO GIRALDO DÁVILA. 2. JUAN PABLO CIRO CARDOSO Nombre:JUAN PABLO CIRO CARDOSO
OBSERVACIONES: | N/A _________________________________________________________________________________

## Universidad del Quindío. Programa de Ingeniería Electrónica

14 El integrante que no asista a la reunión no podrá firmar en otra ocasión, en su lugar, debe escribirse “AUSENTE”; sin embargo, si le podrán ser asignadas responsabilidades.

Número ID. Equipo: | 2K | Nombre del Equipo: | ATLEKTRONIK
Fecha: | [25-05-07] | Hora de Inicio: 11 am | Hora de Finalización: 1 pm
Lugar: | Universidad del quindío (bloque ingenieria)
Product Manager: | Relator: | Santiago Giraldo Davila
PROPÓSITO DE LA REUNIÓN: | Evaluación de las pruebas de estrés y preparación de documentación final.
METAS ALCANZADAS: | 1. Pruebas de estrés superadas; el sistema mecánico es estable. 2. Base de datos optimizada para evitar duplicidad de registros.
TAREAS PENDIENTES Y RESPONSABLES: | 1. Hacer ajustes estéticos al prototipo (cables, pintura, limpieza). (Juan Pablo Ciro Cardoso) 2. Finalizar el informe con resultados gráficos de las pruebas. (Santiago Giraldo Davila)
FIRMAS DE LOS ASISTENTES 14 : | 1. SANTIAGO GIRALDO DAVILA Nombre:SANTIAGO GIRALDO DÁVILA. 2. JUAN PABLO CIRO CARDOSO Nombre:JUAN PABLO CIRO CARDOSO
OBSERVACIONES: | N/A _________________________________________________________________________________

## Universidad del Quindío. Programa de Ingeniería Electrónica

15 El integrante que no asista a la reunión no podrá firmar en otra ocasión, en su lugar, debe escribirse “AUSENTE”; sin embargo, si le podrán ser asignadas responsabilidades.

Número ID. Equipo: | 2K | Nombre del Equipo: | ATLEKTRONIK
Fecha: | [25-05-14] | Hora de Inicio: 11 am | Hora de Finalización: 1 pm
Lugar: | Universidad del quindío (bloque ingenieria)
Product Manager: | Relator: | Santiago Giraldo Davila
PROPÓSITO DE LA REUNIÓN: | Cierre técnico del proyecto, verificación final de rúbrica CDIO.
METAS ALCANZADAS: | 1. Prototipo funcional al 100% de acuerdo con los objetivos iniciales. 2. Documento escrito del informe final terminado en su primera versión.
TAREAS PENDIENTES Y RESPONSABLES: | 1. Revisión ortográfica y de formato del informe final. (Juan Pablo Ciro Cardoso) 2. Preparar la estructura de la presentación (diapositivas) para la sustentación. (Santiago Giraldo Davila)
FIRMAS DE LOS ASISTENTES 15 : | 1. SANTIAGO GIRALDO DAVILA Nombre:SANTIAGO GIRALDO DÁVILA. 2. JUAN PABLO CIRO CARDOSO Nombre:JUAN PABLO CIRO CARDOSO
OBSERVACIONES: | N/A _________________________________________________________________________________

## Universidad del Quindío. Programa de Ingeniería Electrónica

16 El integrante que no asista a la reunión no podrá firmar en otra ocasión, en su lugar, debe escribirse “AUSENTE”; sin embargo, si le podrán ser asignadas responsabilidades.

Número ID. Equipo: | 2K | Nombre del Equipo: | ATLEKTRONIK
Fecha: | [25-05-21] | Hora de Inicio: 11 am | Hora de Finalización: 1 pm
Lugar: | Universidad del quindío (bloque ingenieria)
Product Manager: | Relator: | Santiago Giraldo Davila
PROPÓSITO DE LA REUNIÓN: | Grabación de video de funcionamiento y revisión final de entregables.
METAS ALCANZADAS: | 1. Video demostrativo del proyecto grabado y editado. . 2. Diapositivas para la sustentación terminadas.
TAREAS PENDIENTES Y RESPONSABLES: | 1. Subir todos los códigos finales, BD y documentación al GitHub. (Ambos) 2. Estudiar posibles preguntas de los evaluadores. (Ambos)
FIRMAS DE LOS ASISTENTES 16 : | 1. SANTIAGO GIRALDO DAVILA Nombre:SANTIAGO GIRALDO DÁVILA. 2. JUAN PABLO CIRO CARDOSO Nombre:JUAN PABLO CIRO CARDOSO
OBSERVACIONES: | El repositorio debe quedar público y organizado para la entrega de la próxima semana. _________________________________________________________________________________

## Universidad del Quindío. Programa de Ingeniería Electrónica

17 El integrante que no asista a la reunión no podrá firmar en otra ocasión, en su lugar, debe escribirse “AUSENTE”; sin embargo, si le podrán ser asignadas responsabilidades.

Número ID. Equipo: | 2K | Nombre del Equipo: | ATLEKTRONIK
Fecha: | [25-05-28] | Hora de Inicio: 11 am | Hora de Finalización: 1 pm
Lugar: | Universidad del quindío (bloque ingenieria)
Product Manager: | Relator: | Santiago Giraldo Davila
PROPÓSITO DE LA REUNIÓN: | Ensayo general de la sustentación y entrega final de proyecto.
METAS ALCANZADAS: | 1. Repositorio en GitHub actualizado y verificado. . 2. Ensayo de tiempos de presentación exitoso (duración controlada).
TAREAS PENDIENTES Y RESPONSABLES: | 1. Asistir a la presentación final en el bloque de ingeniería. (Ambos)
FIRMAS DE LOS ASISTENTES 17 : | 1. SANTIAGO GIRALDO DAVILA Nombre:SANTIAGO GIRALDO DÁVILA. 2. JUAN PABLO CIRO CARDOSO Nombre:JUAN PABLO CIRO CARDOSO
OBSERVACIONES: | Cierre formal del proyecto CDIO correspondiente al semestre. ¡Éxitos en la sustentación! _________________________________________________________________________________
