jpapasinstru/CDIO3_Eq-4-_Atlektronik/01_Gestion/veredicto_tecnico_y_el_estandar_de_calidad.pdf

## UNIVERSIDAD DEL QUINDÍO

### Facultad de Ingeniería Programa de Ingeniería Electrónica

# Protocolo de Validación y Verificación Industrial: Golpeómetro Digital

## Proyecto CDIO III: Del çreo que funciona.a

## l .está aprobado”

### Integrantes: Santiago Giraldo Davila Juan Pablo Ciro Cardoso

### Armenia, Quindío

2026

## 1. Introducción

Este reporte técnico detalla el marco de validación para el proyecto ”Golpeómetro Digital”. Bajo la premisa de que la ingeniería se basa en hechos medibles y no en suposiciones, se establecen los protocolos de prueba para transicionar de un prototipo funcional a un sistema validado. El documento define los criterios de éxito mediante la metodología de Definition of Done y describe los procedimientos de laboratorio para certificar el cumplimiento de los mismos.

## 2. Definition of Done (DoD)

A continuación se detallan los parámetros de rendimiento, resistencia y gestión que determinan el estado final del proyecto. Ningún componente se considera terminado sin el cumplimiento estricto de su métrica asociada.

Subsistema | Módulo / Componente | Criterio de Aceptación (Atri-buto) | Métrica / Tolerancia Exacta (El DoD)
Hardware | TEST-HW-01: Galga + HX711 | Precisión de Medición | Error de medición inferior al 5.0 % en un rango de 0 a 100 kg tras calibración por software.
Firmware | Bucle de Control (Main Loop) | Rendimiento del Sistema | Tiempo de ejecución del ciclo completo menor a 20ms, sin uso de funciones bloqueantes.
Mecánica | Chasis y Estructura de Impacto | Resistencia Física | Soporte de impactos repetitivos de alta potencia sin fisuras ni des-ajuste de pernos.
Usabilidad | Interfaz de Usuario (Nextion) | Feedback Visual | Latencia visual menor a 200ms desde la detección del impacto y actualización de datos en tiempo real.
Gestión | Repositorio GitHub | Trazabilidad de Código | 0 Errores de compilación, rama main actualizada con commits que referencian pruebas exitosas.

Cuadro 1: Matriz de Definición de Terminado (DoD) del proyecto.

## 3. Protocolos de Prueba (Validación Industrial)

Se describen los procedimientos paso a paso para la verificación de los componentes críticos.

### 3.1. Protocolo TEST-HW-01: Galga Extensiométrica + HX711

Objetivo: Validar que el sistema de adquisición de datos registre el peso con precisión industrial.

Setup o Prerrequisitos: Alimentación de 5V, módulo HX711, multímetro de precisión y bases acrílicas para permitir la flexión mecánica.

Procedimiento:

1. Adaptar las bases en acrílico para garantizar el punto de flexión de la galga.
2. Establecer la conexión eléctrica entre la galga y la etapa de amplificación (HX711).
3. Realizar la medición del voltaje diferencial generado ante una carga conocida.
4. Registrar el valor numérico tras el proceso de calibración digital.

Parámetros de Prueba: V in = 5V , Icarga = 1A.

Criterio de Aceptación: El error registrado debe ser estrictamente inferior al 5.0 %.

### 3.2. Protocolo TEST-SW-02: Interfaz HMI y Latencia

Objetivo: Asegurar una respuesta visual inmediata para el usuario final.

Procedimiento: Utilizar el cronómetro interno del microcontrolador para medir el tiempo transcurrido desde la superación del umbral de impacto hasta el despliegue del dato en la pantalla Nextion.

Criterio de Aceptación: La latencia total del sistema debe ser menor a 200 ms.

## 4. Conclusiones de Validación

La ejecución de estos protocolos permite certificar que el Golpeómetro Digital no solo es funcional, sino que cumple con los márgenes de error y tiempos de respuesta requeridos para una aplicación de ingeniería electrónica.
