jpapasinstru/CDIO3_Eq-4-_Atlektronik/04_Dossier/Presupuesto_y_Costos.pdf

### Informe de Presupuesto Anual y Viabilidad: Proyecto Golpeometro Digital ´

Autores:

Santiago Giraldo Davila

Juan Pablo Ciro Cardoso

Facultad de Ingenier´ıa

Programa de Ingenier´ıa Electronica ´

Asignatura: CDIO III

Docente:

Ing. Jose Luis Chavez P.

Universidad del Quind´ıo

Armenia, Quind´ıo

9 de abril de 2026

## 1. Introduccion´

El presente documento tiene como objetivo presentar el analisis financiero del proyecto ”Gol- ´

peometro Digital”, enfoc ´ | andose en la transici ´ | on de un prototipo funcional a un producto comercial ´
sostenible. Se detallan los costos de fabricacion e instalaci ´ | on, los gastos operativos fijos y la meta ´

de ventas anual necesaria para garantizar la viabilidad del modelo de negocio.

## 2. Presupuesto de Materiales y Desarrollo

La fase de fabricacion e instalaci ´ | on requiere una inversi ´ | on inicial equilibrada entre capital ´

directo y recursos en especie.

### 2.1. Desglose de Materiales y Suministros (BOM)

En la Tabla 1 se presenta la relacion de componentes del sistema. El costo variable unitario ´

final se ha establecido considerando la fabricacion completa y el servicio de instalaci ´ | on en el sitio ´

final.

Tabla 1
Presupuesto de Materiales y Costos Directos
´Item Descripcion del ´ | Efectivo ($) | Especie ($) | Total ($)
Pantalla Nextion 4.3”(Existente) | 0 | 400.000 | 400.000
Galga de Esfuerzo (1 T) | 150.000 | 0 | 150.000
Microcontrolador ESP32 | 35.000 | 0 | 35.000
Pera de Golpeo Profesional | 80.000 | 0 | 80.000
Fuente de Poder ATX (Reciclada) | 0 | 50.000 | 50.000
Chasis, Cajas y Sujecion´ | 50.000 | 0 | 50.000
Total de Materiales (BOM) | 315.000 | 450.000 | 765.000

## 3. Estructura de Costos Fijos y Metas Operativas

Para asegurar la continuidad de la empresa, se han definido costos fijos que cubren la infraes-

tructura y el talento humano necesario.

### 3.1. Gastos Fijos Anuales

La operacion anual est ´ | a fundamentada en dos rubros principales: el arrendamiento de las ins- ´
talaciones y la remuneracion de un empleado encargado de la gesti ´ | on t ´ | ecnica y operativa. ´

Tabla 2
Costos Fijos Operativos Anuales
Descripcion del Gasto ´ | Valor Anual ($)
Arrendamiento de taller operativo | 12.000.000
Sueldo de empleado (Operacion y mantenimiento) ´ | 18.000.000
Total Costos Fijos (CF) | 30.000.000

## 4. Viabilidad y Punto de Equilibrio

El analisis de sostenibilidad se basa en un margen de contribuci ´ | on que permita absorber los ´

costos fijos anuales mediante la ejecucion de instalaciones programadas. ´

### 4.1. Calculo del Precio de Venta ´

Se define un Costo Variable Unitario (CV U) de $825.000 COP, valor que ya incluye los ma-

teriales, el ensamble y el servicio de instalacion profesional. Aplicando un margen de contribuci ´ | on´

del 40 % sobre el precio final:

P V =

CV U
1 − 0, 40

=

825,000
0, 6
= 1,375,000 | (1)

El precio de venta establecido por unidad instalada es de $1.375.000 COP.

### 4.2. Meta de Instalaciones y Punto de Equilibrio

Para cubrir los $30.000.000 de costos fijos anuales, se calcula el numero de instalaciones m ´ | ´ıni-

mas (Q) mediante la siguiente relacion: ´

Q =

CF
P V − CV U =

30,000,000
550,000
≈ 54, 54 | (2)

Para alcanzar el punto de equilibrio, se requiere realizar un m´ınimo de **55 instalaciones anua-

les**. Sin embargo, la organizacion ha fijado una ´ | meta comercial de 60 instalaciones anuales, lo

cual asegura un margen de utilidad neta y permite la gestion de nuevos proyectos. ´

## 5. Conclusiones

El analisis financiero indica que el proyecto alcanza su punto de equilibrio con un promedio de ´

4.5 instalaciones mensuales. Al establecer la meta en 60 unidades al ano, la empresa garantiza la ˜

cobertura total de sus obligaciones salariales y locativas, manteniendo un precio competitivo en el

sector de equipos deportivos electronicos. ´
