jpapasinstru/CDIO3_Eq-4-_Atlektronik/02_Hardware/Datasheets/datashet esp 32.jpeg

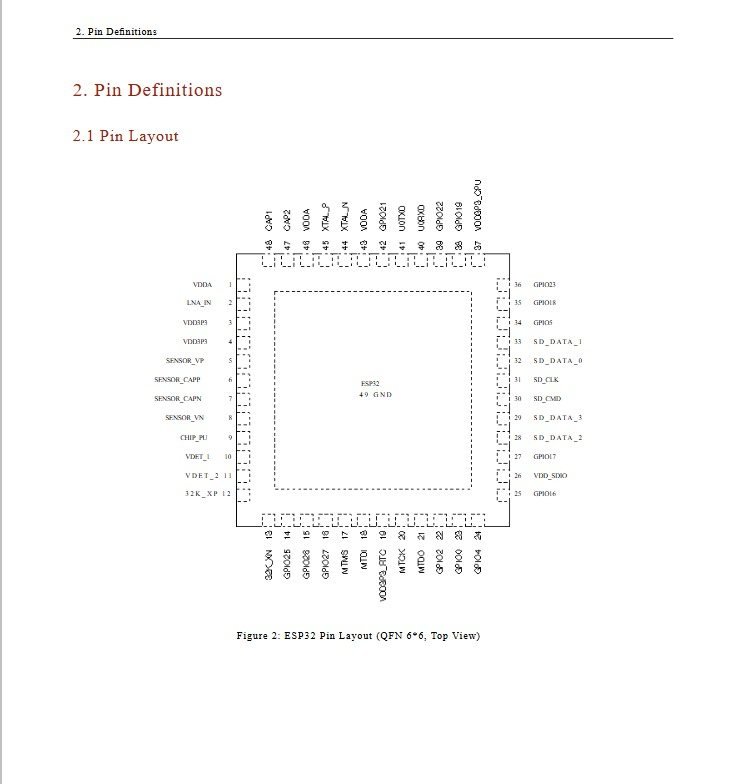
02_Hardware/Datasheets/datashet esp 32.jpeg
