jpapasinstru/CDIO3_Eq-4-_Atlektronik/02_Hardware/Datasheets/datashet hx711.jpeg

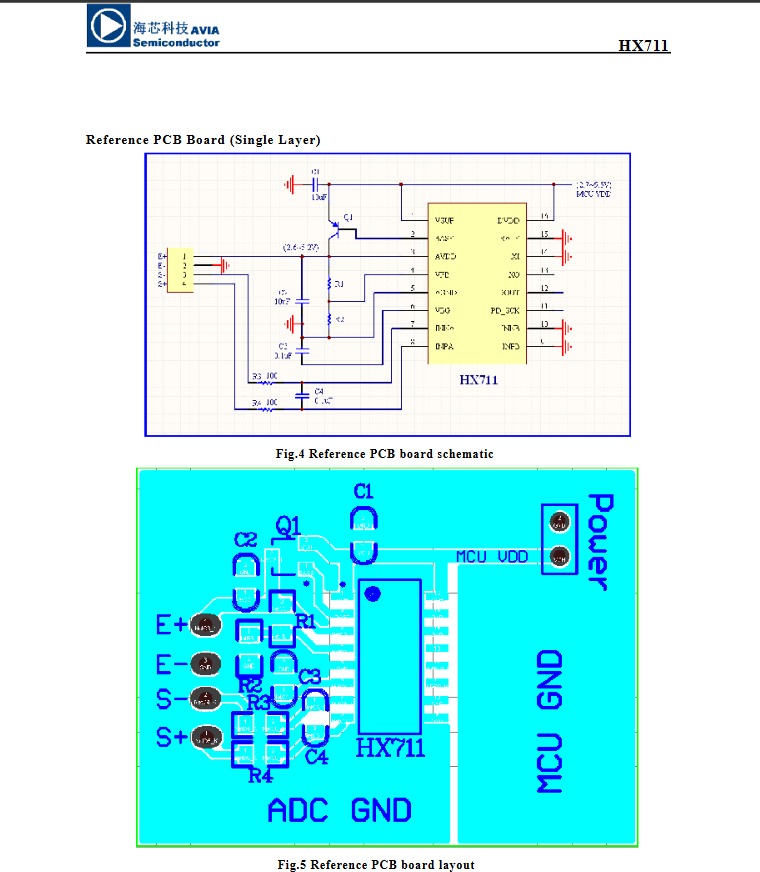
02_Hardware/Datasheets/datashet hx711.jpeg
