jpapasinstru/CDIO3_Eq-4-_Atlektronik/02_Hardware/Datasheets/datashet nextion l.jpeg

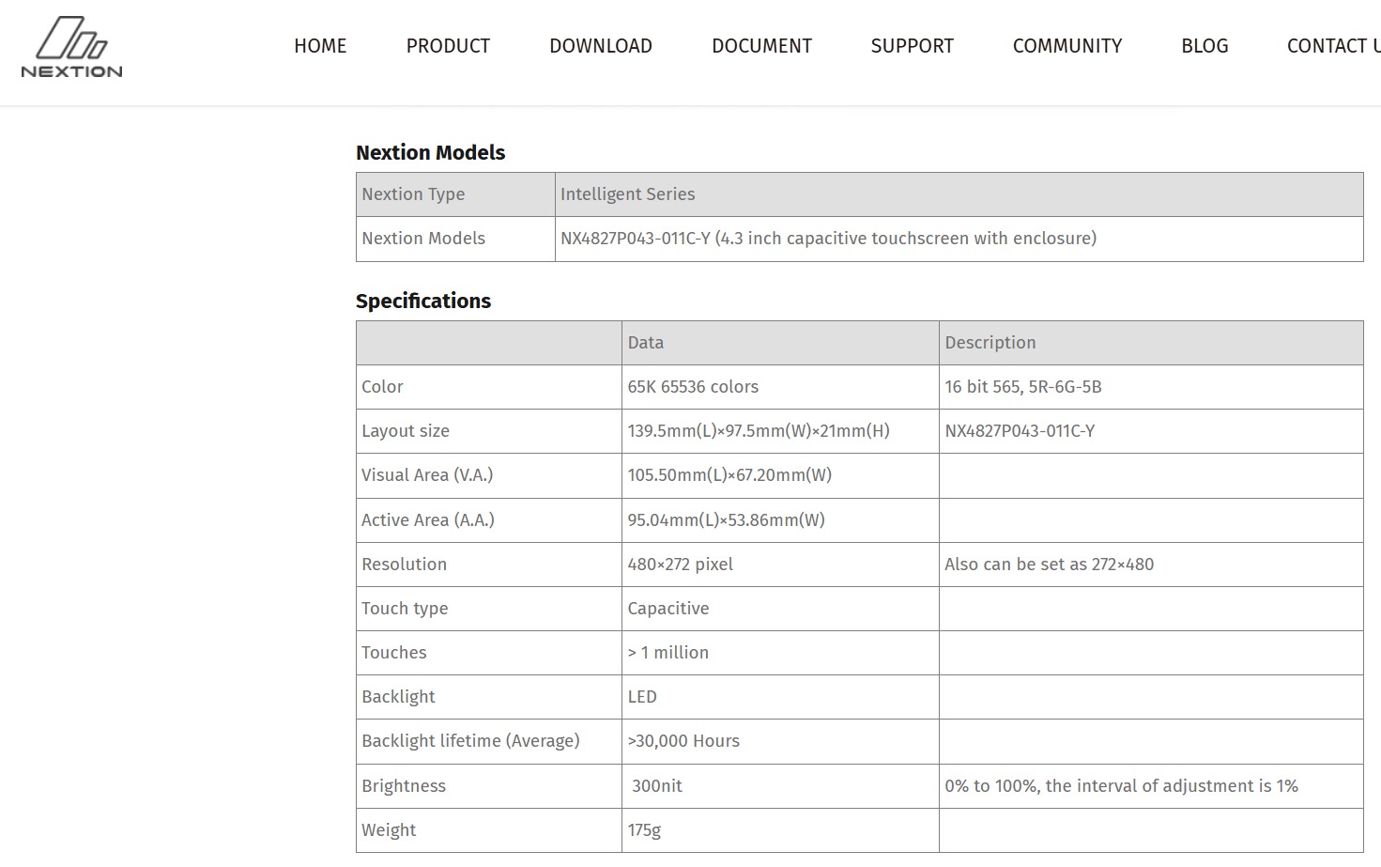
02_Hardware/Datasheets/datashet nextion l.jpeg
