jpapasinstru/CDIO3_Eq-4-_Atlektronik/01_Gestion/boom sourcing cdio 3 atlektronik.xlsx

Nivel | Ítem (Descripción) | MPN (Manufacturer Part Number) | Proveedor (Link) | Costo Unit. | Tiempo de Entrega (Lead Time) | Semáforo de Riesgo
Bajo | Microcontrolador | ESP32 | local | $30000 | inmediato | 🟢 VERDE (Proceder)
Crítico | Sensor de peso | celda de carga NA4-1 | china-encoder | $200000 | 10 Días | 🟡 AMARILLO (Pedir HOY)
Bajo | conversor ADC | HX711 | mercado libre-local | $10000 | 1-2 Días | 🟡 AMARILLO (Pedir HOY)
Bajo | amplificador de instrumentacion | AD-620 | Local | $18000 | Inmediato | 🟢 VERDE (Proceder)
Bajo | elementos del circuito | resistencias, cables, borneras, etc | Local | $10.000-40.000 | inmediato | 🟢 VERDE (Proceder)
Medio | fuente de alimentacion dual | Fuente De Alimentación Switching Metalica 12v 102w 8.5a, Interior | fervicom.com (tienda nacional) | $40.000-50.000 | 2-4 dias | 🟡 AMARILLO (Pedir HOY)
