jpapasinstru/CDIO3_Eq-4-_Atlektronik/01_Gestion/Protocolos de prueba ATLEKTRONIK.xlsx

ID de Prueba | Componente | Prioridad | Descripción / Resumen | Setup y Pre-requisitos | Pasos de Ejecución | Parámetros (Input) | Resultado Esperado | Resultado Obtenido | Estado Final | Ingeniero a Cargo
TEST-HW-01 | GALGA EXTENSIOMETRICA + HX71 | P0 (Crítico) | Validar que la galga entregue un peso conocido. | Alimentacion 5V, conexion HX 711, Multimetro, Bases en acrilico para la deformacion. | 1. Adaptar las bases en acrilico para su deformacion. 2. Conexion con HX 711 3. Medicion de voltaje que entrega la galga. | Vin = 5V I_carga = 1A | Error de medición inferior al 5.0% en un rango de 0 a 100 kg tras calibración por software. |  | ❌ Fail | Juan Pablo Ciro Cardoso
TEST-FW-01 | Pantalla Nextion (interfaz) | P1 (Alto) | Validar lel correcto funcionamiento de la interfaz, ademas de la informacion bidireccional con la esp 32 | ESP32 conectado con RX y TX para la la entrega de informacion bidireccional, y alimentacion a 5V y 1A | 1. Creacion interfaz con el software nextion, y validar el tactil de la pantalla. 2. Validar la comunicacion bidireccional con la esp32 3. Observar la medicion = | Vin= 5-V I_carga = 1A | Interfaz legible bajo luz artificial y actualización de la barra de potencia en tiempo real sin parpadeos (flicker). |  | ❌ Fail | Santiago Giraldo Davila
TEST-MC-01 | Chasis del golpeometro | P1 (Alto) | BOM actualizado y Protocolo de Pruebas con estado PASS en todas las pruebas críticas. | Golpeómetro anclado a base sólida. | 1. Medir dimensiones internas de la carcasa. 2. Insertar la PCB en los rieles guía. 3.Aplicar 10 impactos consecutivos de alta potencia. | Fuerza de impacto (kg), cantidad de golpes. | La PCB debe deslizarse sin forzar y los agujeros de los tornillos deben coincidir perfectamente. |  | ❌ Fail | Juan Pablo Ciro Cardoso
TEST-FW-02 | Código de Control (Firmware) | P1 (Alto) | Verificar la eficiencia y programación no bloqueante del software | ESP32 conectado a PC, Monitor Serial del IDE de Arduino abierto. | 1. Cargar código con medición de tiempo de ciclo. 2. Revisar logs en el monitor serial. 3. Verificar ausencia de "delays" en el código. | Tiempo de ciclo (ms), versión de la rama main. | Ciclo principal con tiempo de ejecución < 20ms, 0 uso de la función delay() y subido a la rama main de GitHub sin errores. |  | ❌ Fail | Santiago Giraldo Davila
TEST-HW-FW-01 | Sistema de Procesamiento (Latencia) | P0 (Crítico) | Medir la velocidad de respuesta total del sistema. | Sistema completo operativo (Celdas + ESP32 + Nextion). | 1. Iniciar temporizador interno en el trigger de carga. 2. Detener temporizador al enviar datos a pantalla. 3. Registrar el tiempo total. | Tiempo de respuesta (ms). | El tiempo desde el impacto detectado hasta la visualización del resultado en la Nextion debe ser < 200 ms. |  | ❌ Fail | Santiago Giraldo Davila
TEST-DC-01 | Documentación de Gestión | P2 (Medio) | Asegurar la trazabilidad y el inventario final del proyecto. | Repositorio de GitHub actualizado, lista de precios de proveedores locales. | 1. Cotejar componentes físicos vs lista en archivo. 2. Verificar estado de pruebas en el protocolo. | Cantidad de componentes, enlaces de GitHub. | BOM actualizado y Protocolo de Pruebas con estado PASS en todas las pruebas críticas. |  | ❌ Fail | Juan Pablo Ciro Cardoso
