jpapasinstru/CDIO3_Eq-4-_Atlektronik/01_Gestion/Protocolos de prueba ATLEKTRONIK (1).xlsx

ID de Prueba | Componente | Prioridad | Descripción / Resumen | Setup y Pre-requisitos | Pasos de Ejecución | Parámetros (Input) | Resultado Esperado | Resultado Obtenido | Estado Final | Ingeniero a Cargo
TEST-HW-01 | GALGA EXTENSIOMETRICA + HX71 | P0 (Crítico) | Validar que la galga entregue un peso conocido mediante un dato que entrega la galga extensiometrica para correcto uso. | Alimentacion 5V, conexion HX 711, Multimetro, Bases en acrilico para la deformacion, objetos con peso conocido. | 1. Adaptar las bases en acrilico para su deformacion 2. Conexion con HX 711 3. Medicion de voltaje que entrega la galga y su calibracion para para entrega de peso conocido. | Vin = 5V, dato entregado por la celda para su calibracion, voltaje de salida de la galga extensiometrica I_carga = 1A | Error de medición inferior al 5.0% en un rango de 0 a 100 kg tras calibración. | Al medir un peso patrón con la celda de carga calibrada, se registró un error aproximado del 3.0%. No obstante, se observó una limitación en el tiempo de medición de la galga extensométrica, debido a que el impacto solo se registra de manera efectiva si se aplica con precisión en el punto central. | ✅ Pass | Juan Pablo Ciro Cardoso
TEST-FW-01 | Pantalla Nextion (interfaz) | P0 (Crítico) | Validar el correcto funcionamiento de la interfaz, ademas de la informacion bidireccional con la esp 32 | ESP32 conectado con RX y TX para la la entrega de informacion bidireccional, y alimentacion a 5V y 1A, computador y software nextion para la programacion grafica y de lenguaje C con comunicacion entre pantalla nextion-esp32. | 1. Creacion interfaz con el software nextion, y validar el tactil de la pantalla. 2. Validar la comunicacion bidireccional con la esp32 3. Observar la medicion de fuerza, visualizacion de usuarios registrados e impactos de la fuerza. | Vin= 5-Vm ,Fuerza calculada, base de datos de usuarios registrados, comparacion entre la relacion peso-golpe. I_carga = 1A | Interfaz de usuario: Legible bajo condiciones de luz artificial y con actualización de la barra de potencia en tiempo real sin parpadeos (flicker). Procesamiento de datos: Visualización de la fuerza de impacto, almacenamiento del golpe de mayor potencia (récord) y registro en la base de datos de los últimos 5 impactos. Retroalimentación: Emisión de un mensaje de felicitación o una recomendación para ajustar la técnica del último golpe. | Todos los parámetros están funcionales. La barra de potencia se actualiza dinámicamente de acuerdo con la fuerza del impacto del usuario; asimismo, dicho valor se muestra en pantalla durante 3 segundos antes de restablecerse para un nuevo intento. Por otra parte, los últimos 5 impactos quedan registrados en la base de datos y se visualizan en la pantalla Nextion. Finalmente, el sistema evalúa al usuario según su peso e impacto, indicándole si su golpe se encuentra en un rango óptimo y si está mostrando una mejora en su rendimiento. | ✅ Pass | Santiago Giraldo Davila
TEST-MC-01 | Chasis del golpeometro | P1 (Alto) | Validar un sistema robusto que soporte impactos de gran escala y el correcto funcionamiento del movimiento de la pera en 1 solo sentido | Marcos de aluminio anclados a una base de manera donde estara adaptado la celda de carga y la pantalla nextion,sistema de movimiento en 1 solo sentido,pera de boxeo con buen acolchonamiento. | 1. Medir dimensiones internas de la carcasa para insertar la pantalla y dimensiones del sistema para movimiento en un solo sentido. 2. Insertar la PCB en la parte trasera y hacer las perforaciones para ocultar el cable de conexiones. 3.Aplicar 10 impactos consecutivos de alta potencia y corroborar la base de datos y su medicion. | Fuerza de impacto (kg), cantidad de golpes, medicion y rigidez. | "La PCB debe estar anclada de forma holgada sin someterse a tensiones mecánicas, garantizando que los agujeros de sujeción coincidan perfectamente con los tornillos. Asimismo, la estructura debe asegurar que los impactos de alta potencia no generen vibraciones que interfieran con la comunicación del sistema. | El sistema es robusto y soporta impactos de alta potencia sin interferir en la visualización o en la precisión de la medición. Adicionalmente, cuenta con una excelente presentación estética, ya que todo el cableado se encuentra completamente oculto e integrado en la estructura. | ✅ Pass | Juan Pablo Ciro Cardoso
TEST-FW-02 | Código de Control (Firmware) | P1 (Alto) | Verificar la eficiencia y programación no bloqueante del software | ESP32 conectado con PC mediante Wifi, pantalla Nextion conectado a ESP32 con RX y TX, Base de datos mediante python. | 1. Cargar código con medición de tiempo de ciclo. 2. Revisar logs en el monitor serial. 3. Verificar ausencia de "delays" en el código. | Tiempo de ciclo (ms), versión de la rama principal y uso de la funcion millis para evitar bloqueos. | Tiempo de ciclo: Ciclo principal con un tiempo de ejecución inferior a 20 ms. Gestión de datos: Almacenamiento en la base de datos mediante un flujo de información transmitido en la arquitectura ESP32 - Nextion - Python. | El sistema registra un tiempo de respuesta o de guardado de datos de entre 20 ms y 100 ms. Debido a esto, la pantalla Nextion generaba interferencias o errores si se reducía el tiempo de visualización; este comportamiento ocurría porque la pantalla experimentaba conflictos de sincronización al enviar y recibir datos de manera simultánea. | ✅ Pass | Santiago Giraldo Davila
TEST-HW-FW-01 | Sistema de Procesamiento (Latencia) | P0 (Crítico) | Medir el tiempo de respues del sistema al guardar datos y digitalizarlos en el interfaz del usuario. | Sistema completo operativo (Celdas + ESP32 + Nextion+Python). | 1. Iniciar temporizador interno en el trigger de carga. 2. Detener temporizador al enviar datos a pantalla. 3. Registrar el tiempo total. | Tiempo de respuesta (ms). | El tiempo transcurrido desde la detección del impacto hasta la visualización del resultado en la pantalla Nextion debe ser inferior a 200 ms. | Se cumplió con este parámetro, ya que al establecer el tiempo de visualización en 150 ms para que el usuario observe sus mediciones, el sistema operó de manera estable y sin errores. | ✅ Pass | Santiago Giraldo Davila
TEST-DC-01 | Documentación de Gestión | P2 (Medio) | Asegurar la trazabilidad y el inventario final del proyecto con todos los documentos terminados y subidos al Github. | Repositorio de GitHub actualizado, lista de precios de proveedores locales,protocolos de pruebas y manual de tecnico. | 1. Cotejar componentes físicos vs lista en archivo. 2. Verificar estado de pruebas en el protocolo. | Cantidad de componentes, enlaces de GitHub. | El listado de materiales (BOM) se encuentra completamente actualizado, y el protocolo de pruebas registró un estado satisfactorio (PASS) en la totalidad de las pruebas críticas. | Se actualizó el repositorio de GitHub con toda la documentación requerida. Esta incluye desde la lista de componentes utilizados y el protocolo de pruebas, hasta el respectivo manual de usuario. | ✅ Pass | Juan Pablo Ciro Cardoso
