jpapasinstru/CDIO3_Eq-4-_Atlektronik/(list of files, drawings)

Other design files:
02_Hardware/Source/simulacion_celda_de_carga_ad620.pdsprj
