jpapasinstru/CDIO3_Eq-4-_Atlektronik/(commit log)

2026-02-16 Create README1.md
    Solo PDFs de componentes comprados
2026-02-16 Create README.md
    Archivos STL, DXF y CAD de carcasas
2026-02-16 Update README with file format information
    Added a note about STL, DXF, and CAD files for enclosures.
2026-02-16 Create README.md
    Archivos editables: KiCad, Altium, Eagle
2026-02-16 Create README.md
    solo PDFs de componentes comprados
2026-02-16 Create README.md
    instrucciones de compilación
2026-02-24 Update README with calibration code for HX711
    Added calibration process code for load cell and HX711 module.
2026-02-24 Actas de reunion
2026-02-24 acta de reuniones
2026-03-02 4 actas de reunion
2026-03-02 cronograma y boom
    [boom sourcing cdio 3 atlektronik.xlsx, cronograma ATLEKTRONIK semestre 2026-1.xlsx]
2026-03-03 simu proteus celda de carga
    [simulacion_celda_de_carga_ad620.pdsprj]
2026-04-15 Gestion y veredicto
    [Protocolos de prueba ATLEKTRONIK.xlsx]
2026-05-04 Create ~$Protocolos de prueba ATLEKTRONIK.xlsx
2026-05-20 Create Protocolos de prueba ATLEKTRONIK (1).xlsx
    Actualizacion
    [Protocolos de prueba ATLEKTRONIK (1).xlsx]
